semaurer01/Senior_project/README.md

This is the Git Hub Ropository for My senior project. I am using it to store and track changes in my design and record my progress.
