semaurer01/Senior_project/wires.txt

Resistor Values
R1=1.8kΩ
R2=1.9kΩ
R3=10kΩ

Arduino
Arduino GND        |GND
Arduino Vin        |5v

GPS
GPS QWIIC          |Arduino QWIIC

MPU
MPU VCC            |5v
MPU GND            |GND
MPU SCL            |Arduino D19
MPU SDA            |Arduino D18
MPU AD0            |5v

Bluetooth
BT Vcc             |5v
BT GND             |GND
BT Tx              |Andiuno D1
BT Rx              |NODE 1

ESC
ESC GND            |GND
ESC 5v             |5v
ESC input          |Arduino D8

Servo
Servo GND          |GND
Servo 5v           |5v
Servo input        |Arduino D4

Speedometers
speedometer1 Vcc   |5v
speedometer1 GND   |GND
speedometer1 out   |Arduino D2

speedometer2 Vcc   |5v
speedometer2 GND   |GND
speedometer2 out   |Arduino D3

Input Switches
S1-                |Arduino D5
S1+                |5v

Resistors
R1+                |Arduino D0
R1-                |Node 1
R2+                |NODE 1
R2-                |GND
R3+                |Arduino D5
R3-                |GND
