semaurer01/Senior_project/print_files/lid.stl

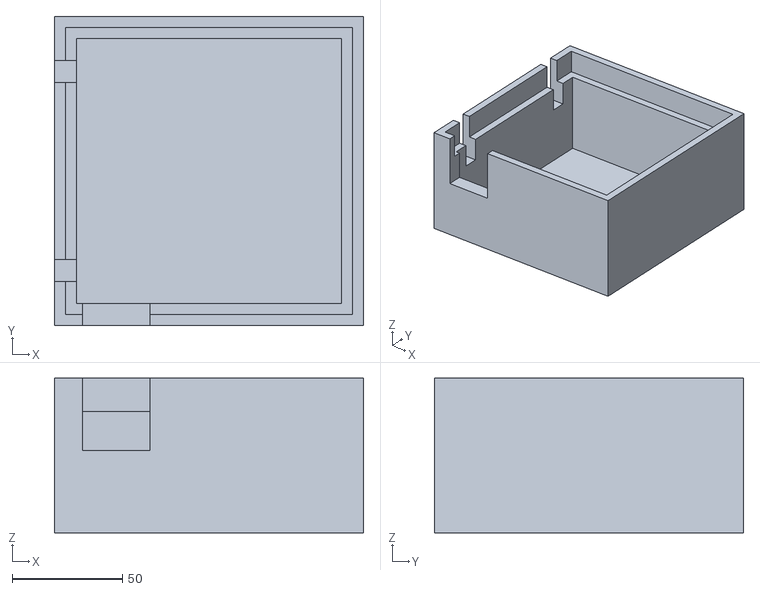
[picture p1: CAD file, 2026-04-15]
print_files/lid.stl
140.0 x 140.0 x 70.0
