semaurer01/Senior_project/print_files/Interuptor.stl

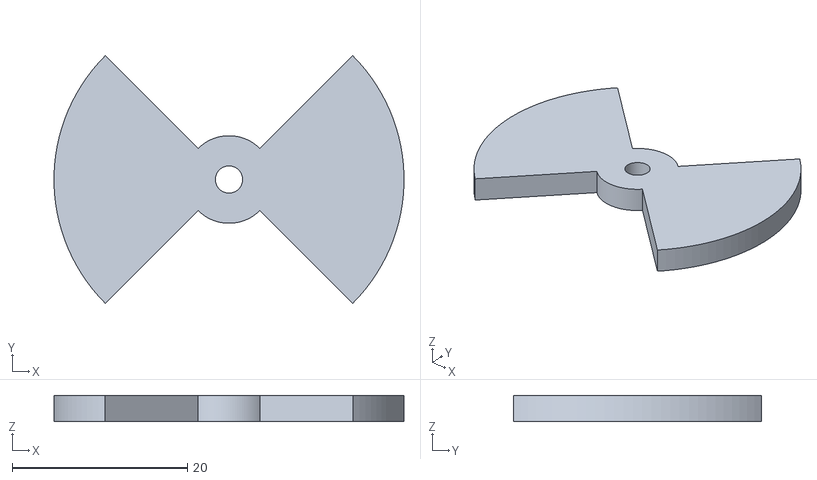
[picture p2: CAD file, 2026-04-10]
print_files/Interuptor.stl
40.0 x 28.3 x 3.00
