semaurer01/Senior_project/print_files/Gear Box Top.stl

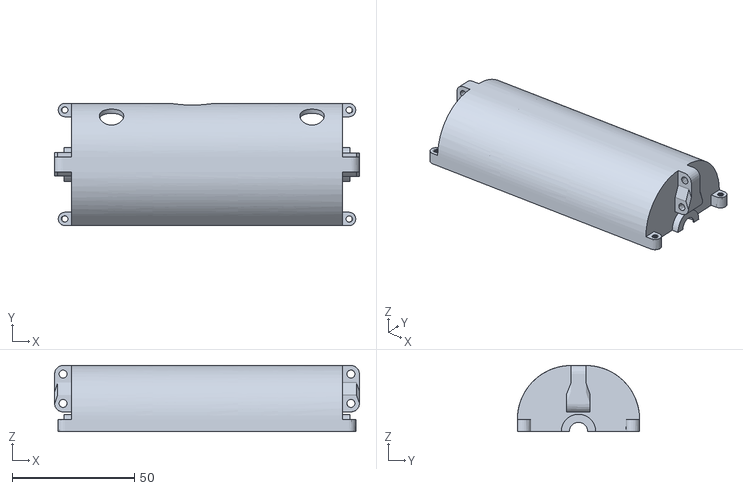
[picture p3: CAD file, 2026-03-26]
print_files/Gear Box Top.stl
124.7 x 50.0 x 27.0
