semaurer01/Senior_project/print_files/Base.stl

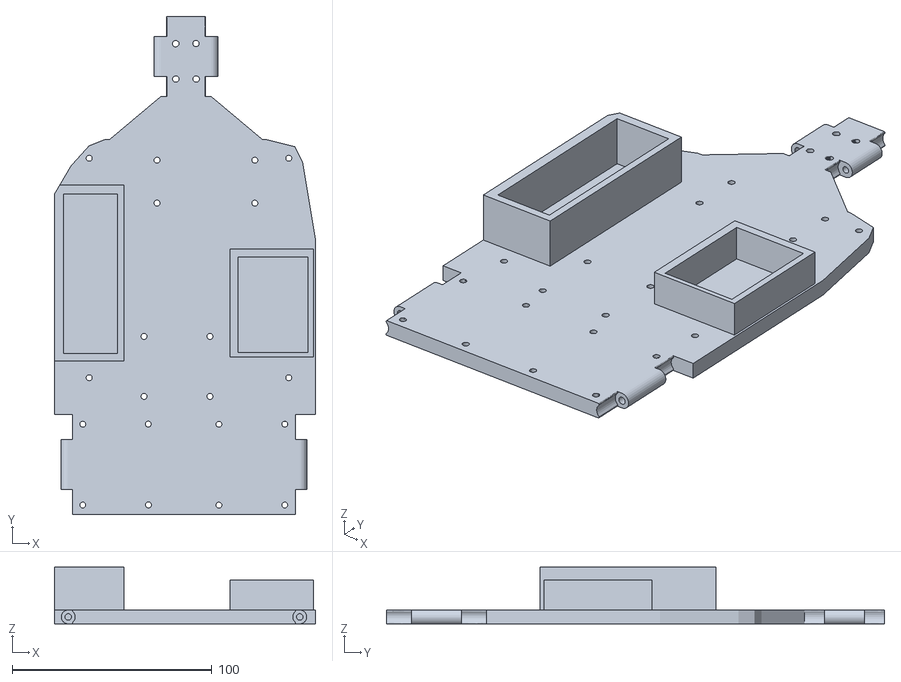
[picture p4: CAD file, 2026-03-26]
print_files/Base.stl
131.0 x 249.5 x 28.5
