semaurer01/Senior_project/print_files/Gear Box Bottom.stl

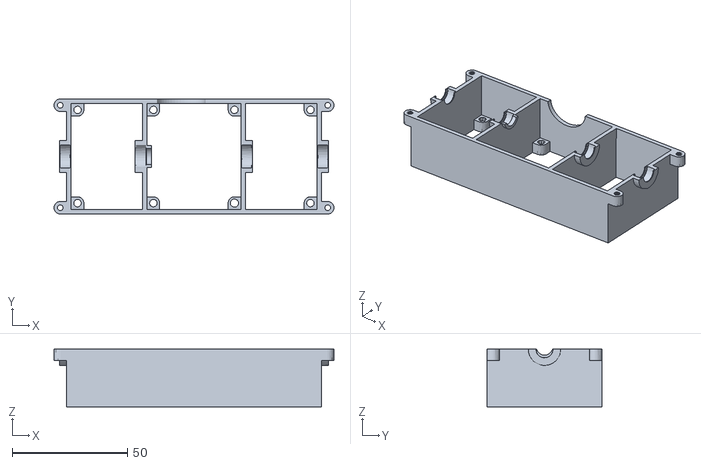
[picture p5: CAD file, 2026-03-26]
print_files/Gear Box Bottom.stl
121.6 x 50.0 x 25.0
