semaurer01/Senior_project/print_files/Front arm top.stl

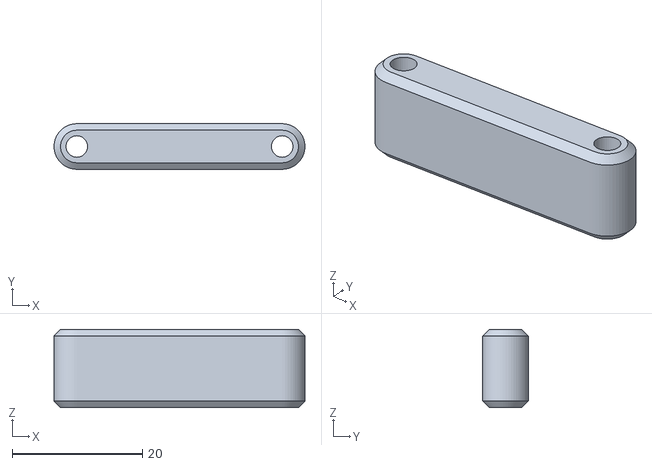
[picture p6: CAD file, 2026-02-25]
print_files/Front arm top.stl
38.5 x 7.00 x 12.0
