semaurer01/Senior_project/print_files/Large gear.stl

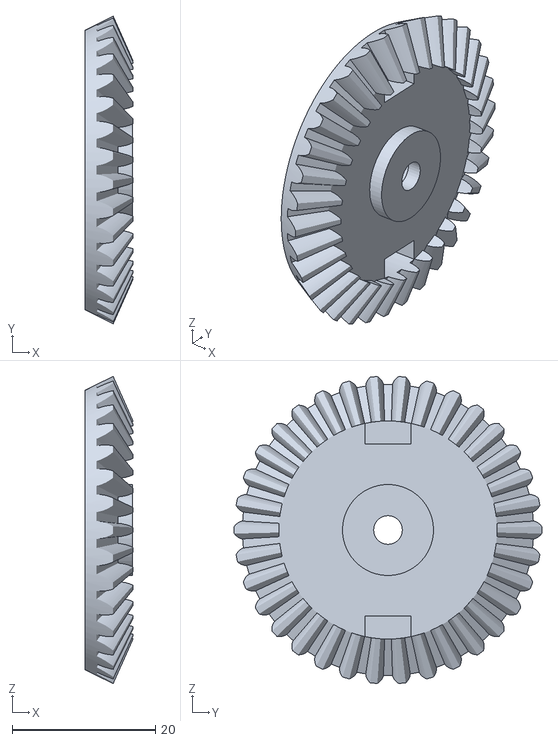
[picture p7: CAD file, 2026-02-25]
print_files/Large gear.stl
6.74 x 43.0 x 42.9
