semaurer01/Senior_project/print_files/Back Suspension.stl

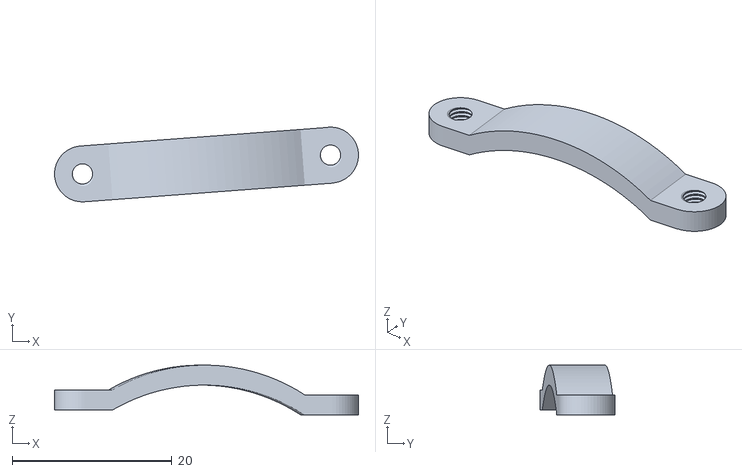
[picture p8: CAD file, 2026-02-25]
print_files/Back Suspension.stl
38.0 x 9.35 x 6.22
