semaurer01/Senior_project/print_files/Back Tyre.stl

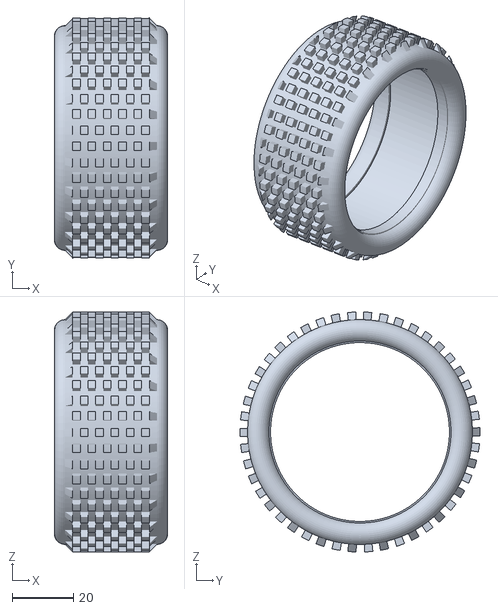
[picture p9: CAD file, 2026-02-25]
print_files/Back Tyre.stl
37.0 x 78.4 x 78.4
