semaurer01/Senior_project/print_files/Front Tire.stl

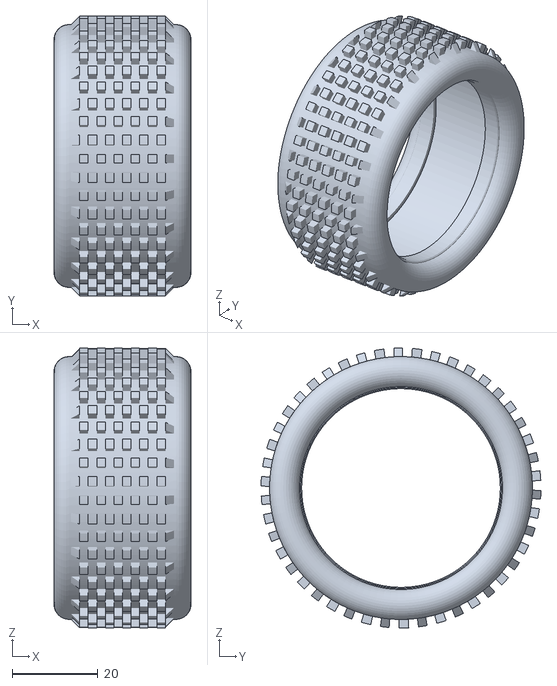
[picture p10: CAD file, 2026-02-25]
print_files/Front Tire.stl
32.0 x 65.4 x 65.4
