semaurer01/Senior_project/print_files/Back wheel.stl

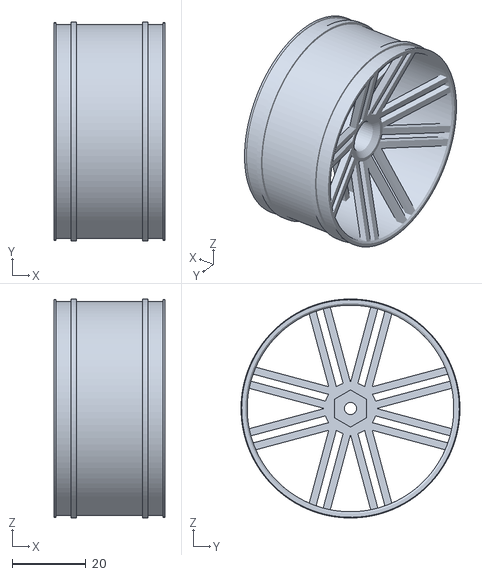
[picture p11: CAD file, 2026-02-25]
print_files/Back wheel.stl
30.0 x 59.4 x 59.4
