semaurer01/Senior_project/print_files/Back Arm.stl

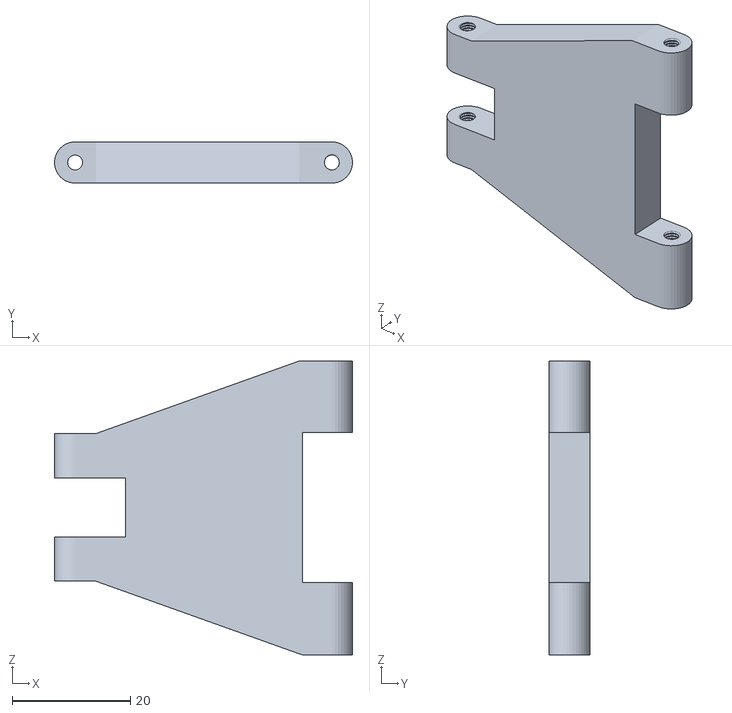
[picture p12: CAD file, 2026-02-25]
print_files/Back Arm.stl
50.5 x 7.00 x 49.8
