semaurer01/Senior_project/print_files/Small Gear.stl

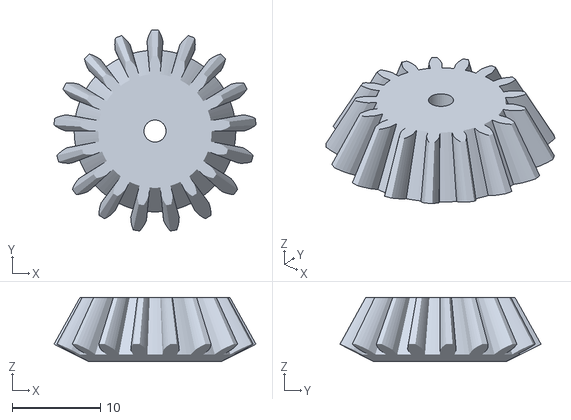
[picture p13: CAD file, 2026-02-25]
print_files/Small Gear.stl
22.9 x 22.8 x 7.28
