semaurer01/Senior_project/print_files/Front Right arm.stl

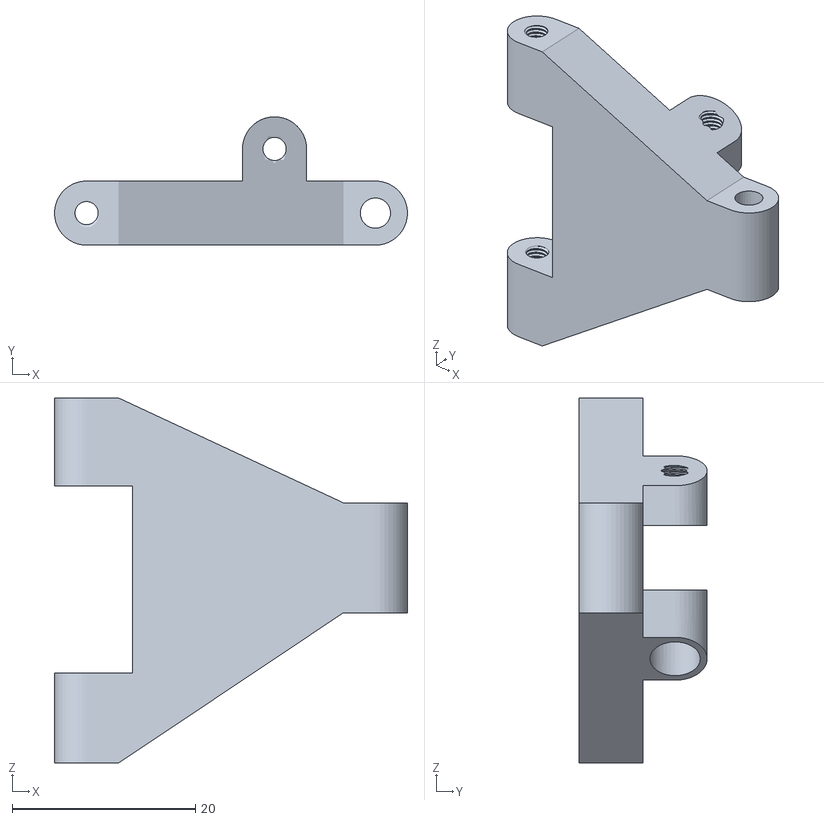
[picture p14: CAD file, 2026-02-25]
print_files/Front Right arm.stl
38.5 x 14.0 x 39.8
