semaurer01/Senior_project/print_files/Front Suspension.stl

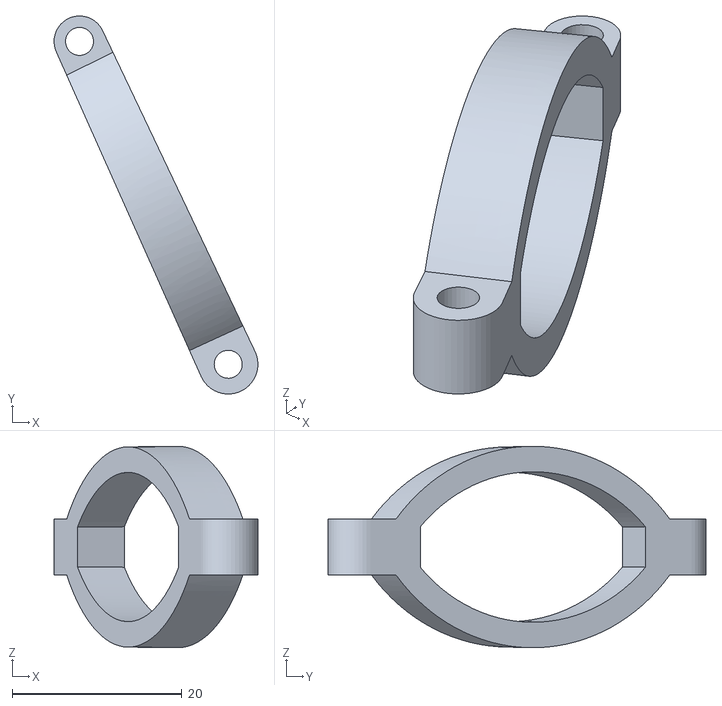
[picture p15: CAD file, 2026-02-25]
print_files/Front Suspension.stl
24.0 x 44.5 x 23.7
