semaurer01/Senior_project/print_files/Gear Arm.stl

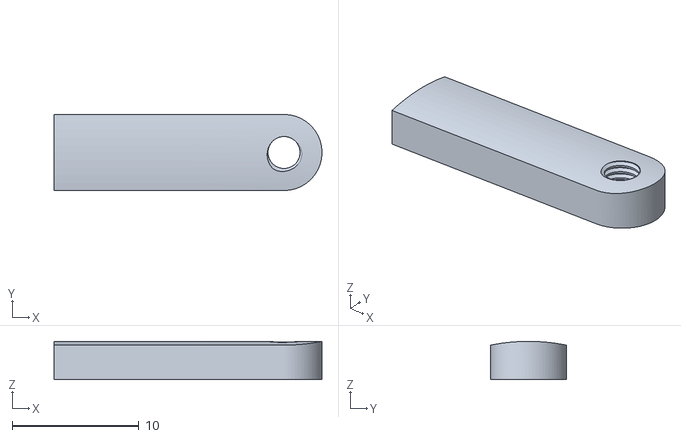
[picture p16: CAD file, 2026-02-25]
print_files/Gear Arm.stl
21.2 x 6.00 x 3.02
