semaurer01/Senior_project/print_files/trellis.stl

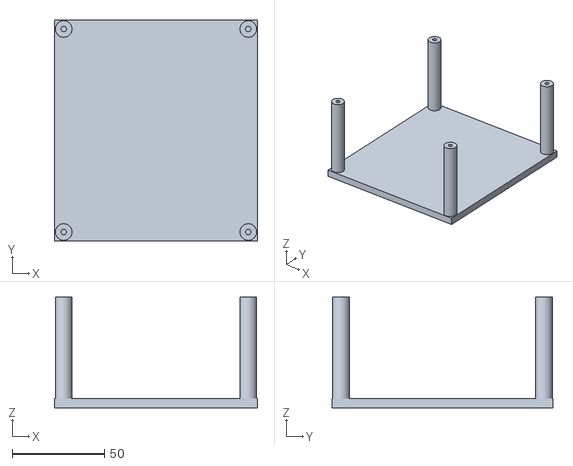
[picture p17: CAD file, 2026-02-25]
print_files/trellis.stl
110.0 x 120.0 x 60.0
