semaurer01/Senior_project/print_files/Inner Driver Gear.stl

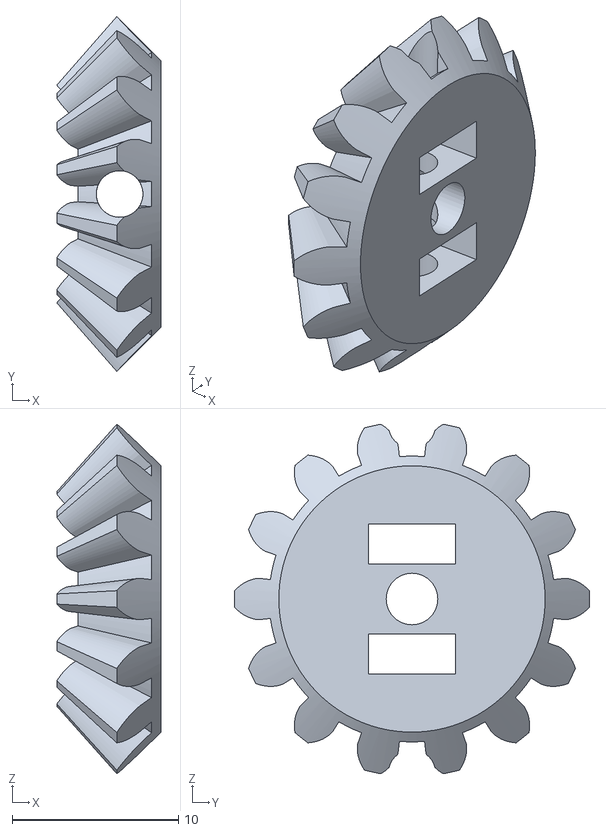
[picture p18: CAD file, 2026-02-25]
print_files/Inner Driver Gear.stl
6.28 x 21.3 x 21.0
