semaurer01/Senior_project/print_files/Front Steering center.stl

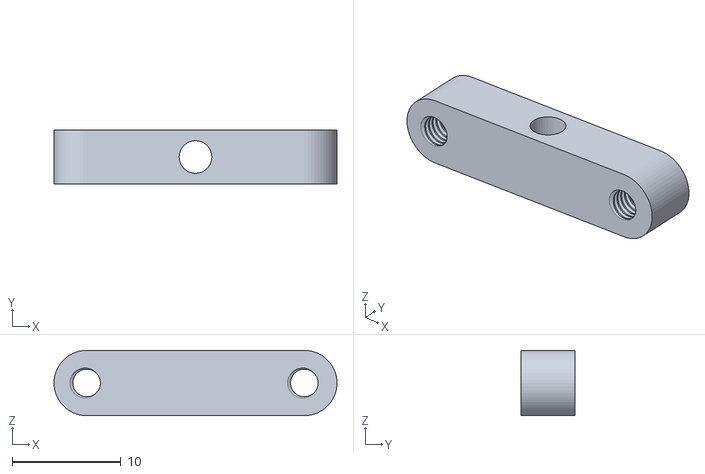
[picture p19: CAD file, 2026-02-25]
print_files/Front Steering center.stl
26.0 x 5.00 x 6.00
