semaurer01/Senior_project/print_files/Steering Bracket.stl

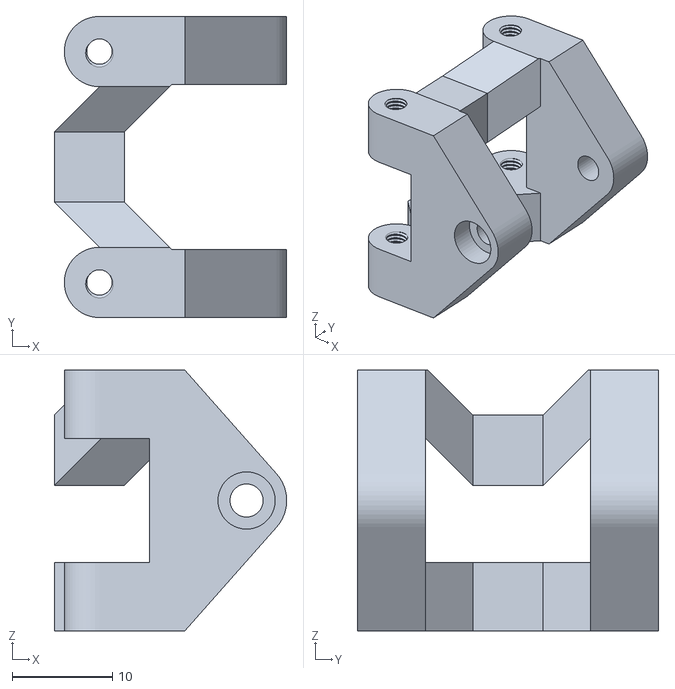
[picture p20: CAD file, 2026-02-25]
print_files/Steering Bracket.stl
23.2 x 30.0 x 26.0
