semaurer01/Senior_project/print_files/Gearbox Connector.stl

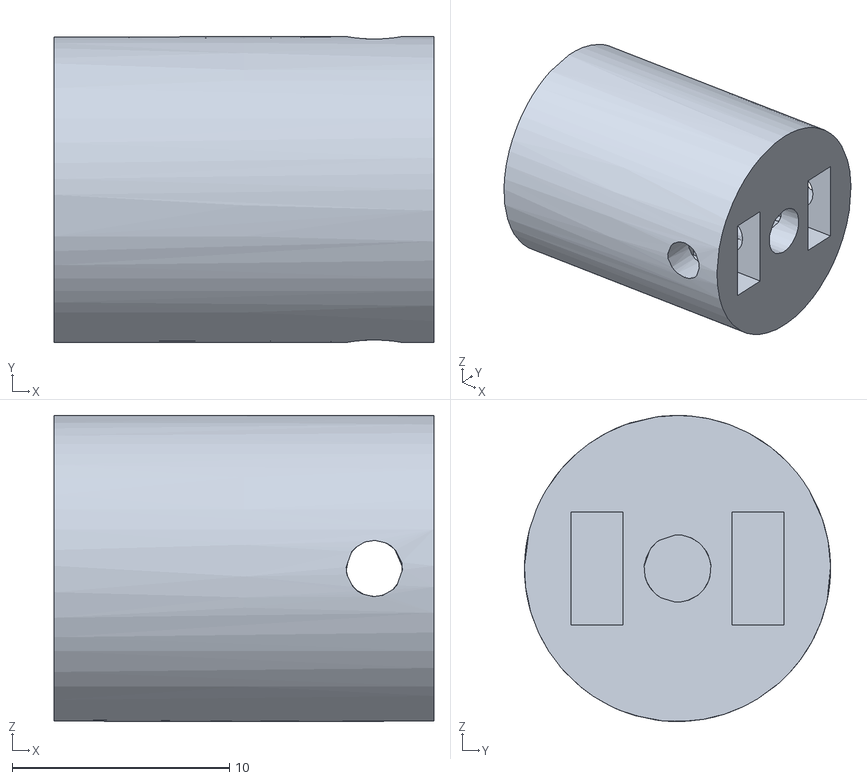
[picture p21: CAD file, 2026-02-25]
print_files/Gearbox Connector.stl
17.5 x 14.1 x 14.1
