semaurer01/Senior_project/print_files/Back Wheel Connector.stl

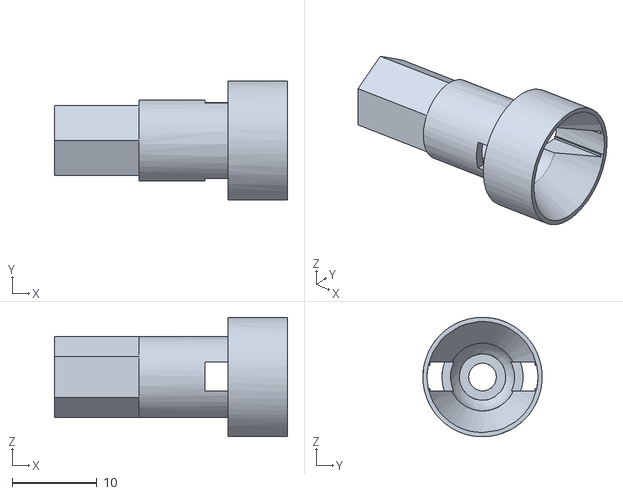
[picture p22: CAD file, 2026-02-25]
print_files/Back Wheel Connector.stl
27.5 x 14.1 x 14.1
