semaurer01/Senior_project/print_files/Back+top+arm.stl

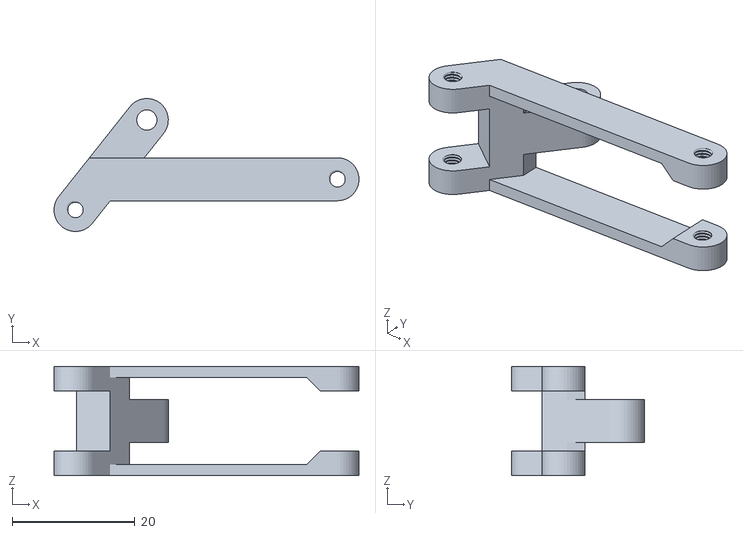
[picture p23: CAD file, 2026-02-25]
print_files/Back+top+arm.stl
49.6 x 21.6 x 17.8
