semaurer01/Senior_project/print_files/Driver arm.stl

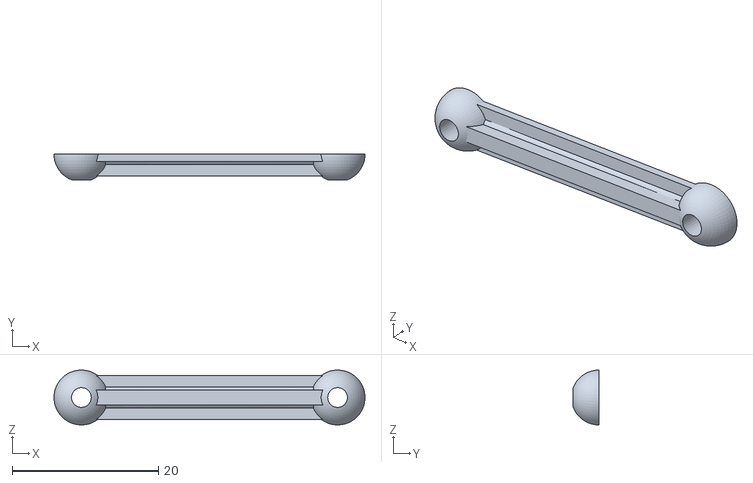
[picture p24: CAD file, 2026-02-25]
print_files/Driver arm.stl
42.5 x 3.50 x 7.49
