semaurer01/Senior_project/print_files/Front Steering arm.stl

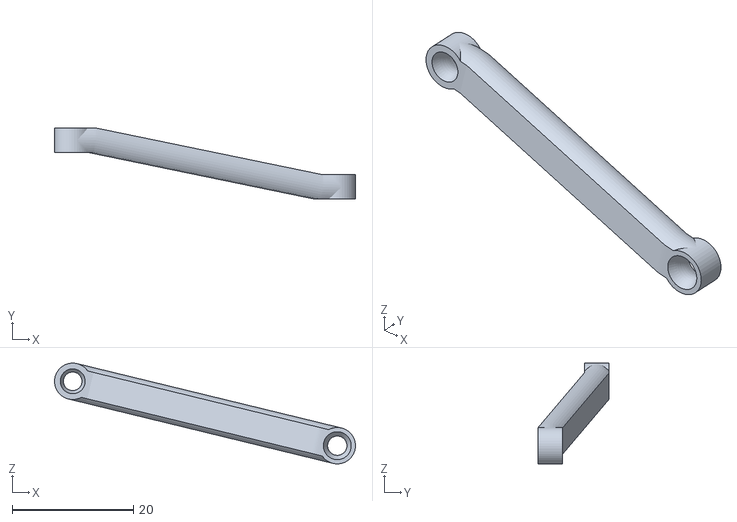
[picture p25: CAD file, 2026-02-25]
print_files/Front Steering arm.stl
49.6 x 11.7 x 16.6
