semaurer01/Senior_project/print_files/Inner gear.stl

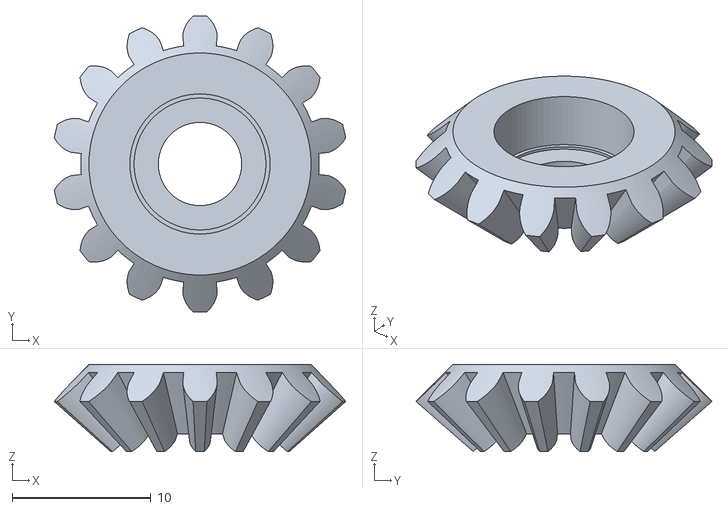
[picture p26: CAD file, 2026-02-25]
print_files/Inner gear.stl
21.0 x 21.3 x 6.28
