semaurer01/Senior_project/print_files/Wheel Bracket Right.stl

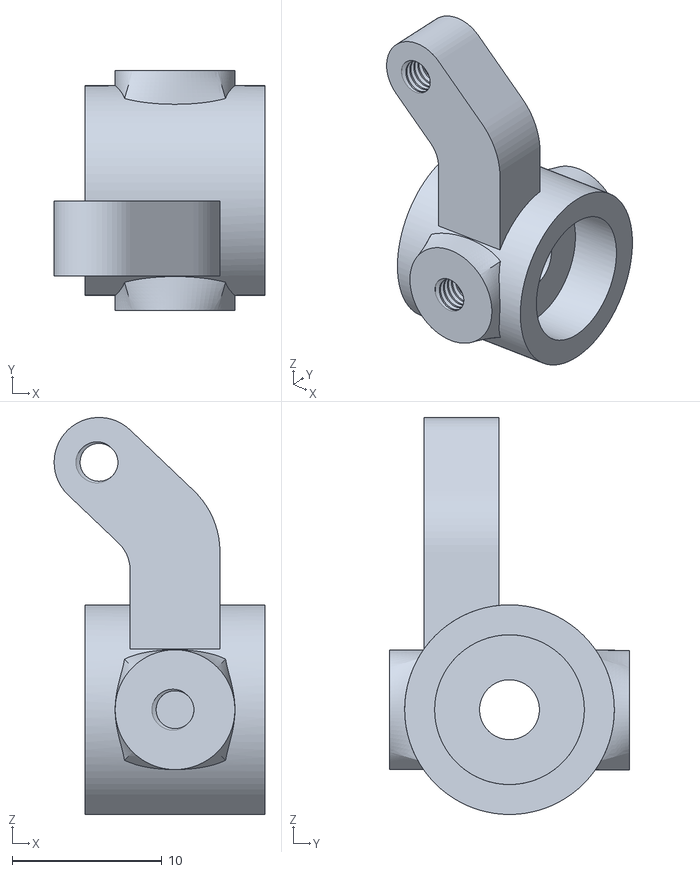
[picture p27: CAD file, 2026-02-25]
print_files/Wheel Bracket Right.stl
14.1 x 16.0 x 26.5
