semaurer01/Senior_project/print_files/Front wheel.stl

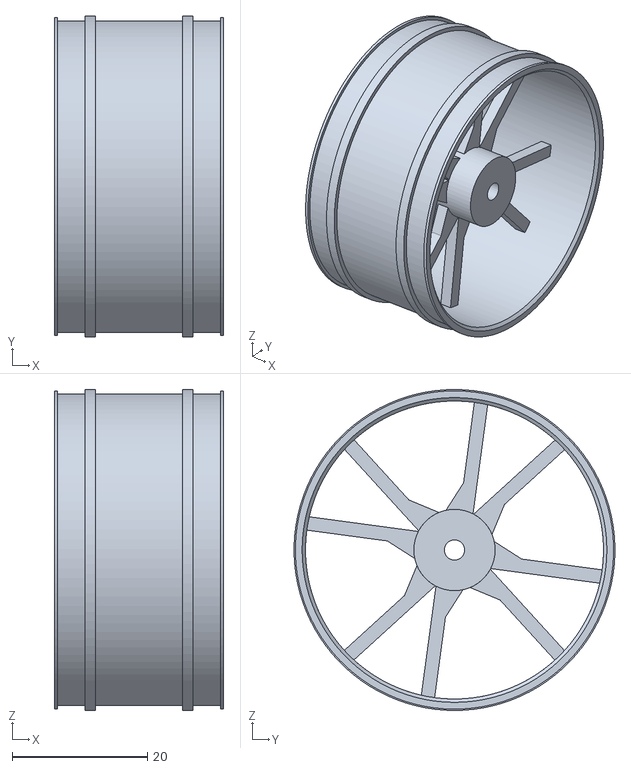
[picture p28: CAD file, 2026-02-25]
print_files/Front wheel.stl
25.0 x 47.4 x 47.4
