semaurer01/Senior_project/print_files/Motor mount.stl

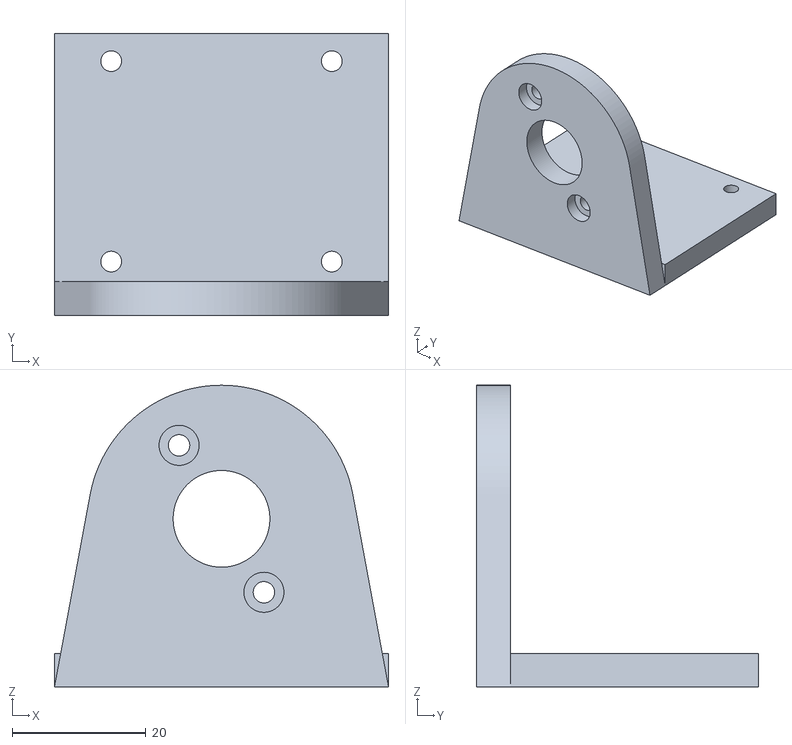
[picture p29: CAD file, 2026-02-25]
print_files/Motor mount.stl
50.0 x 42.2 x 45.1
