semaurer01/Senior_project/print_files/Servo mount.stl

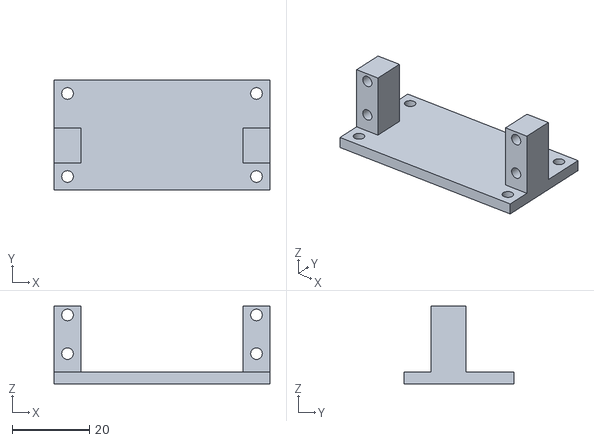
[picture p30: CAD file, 2026-02-25]
print_files/Servo mount.stl
55.9 x 28.5 x 20.1
