semaurer01/Senior_project/(list of files, cad)

Other CAD files:
print_files/Front Left Arm.stl
print_files/Front arm Bracket.stl
print_files/Wheel Bracket Left.stl
print_files/Long washer.stl
