semaurer01/Senior_project/(commit log)

2026-01-28 added Servo test for verifying servo functionality (the steering servo works)
2026-01-29 designed method to test the functionality of the bluetooth device
2026-01-31 This code verifies the connectivity of IIC devices.
2026-02-03 Fixed configuration issues in the setup function allowing the GPS to opperate over QWIIC (WIRE 1) reliably.
    [GPS_test.ino]
2026-02-24 allows the user to set the angle of the servo with macros. This fixes the problem of the motor overthottling and tearing the car apart.
    [Servo_test.ino]
2026-02-24 This will be the main program the vehicle runs while on the course however it currently does nothing and is only a place to put stuff while I figure out how it works
2026-02-25 Added throttle and steering so now the Machine can drive in a strait line.
2026-02-25 This is a file to test the gyroscope and accelerometer module and to measure the offsets caused by the imprecision of the system.
2026-02-25 add print files
    I was advised that the printing files should be in the Github repository so I am adding them now.
    [Back Tyre.stl, Back Wheel Connector V2.stl, Back wheel.stl, Back+Arm.stl, Back+Suspension.stl, Back+top+arm.stl, Base V3.stl, Driver+arm.stl]
2026-02-25 creating folder to store print files
    [Back Tyre.stl]
2026-02-25 put back wheel connector into print_files
    [Back Wheel Connector.stl]
2026-02-25 Rename Back wheel.stl to print_files/Back wheel.stl
    [Back wheel.stl]
2026-02-25 Rename Back+Arm.stl to print_files/Back Arm.stl
    [Back Arm.stl]
2026-02-25 Rename Back+Suspension.stl to print_files/Back Suspension.stl
    [Back Suspension.stl]
2026-02-25 Rename Base V3.stl to print_files/Base.stl
    [Base.stl]
2026-02-25 Rename Driver+arm.stl to print_files/Driver arm.stl
    [Driver arm.stl]
2026-02-25 Rename Front+Left+Arm.stl to print_files/Front Left Arm.stl
    [Front Left Arm.stl, Front+Left+Arm.stl]
2026-02-25 Rename Front+Right+arm.stl to print_files/Front Right arm.stl
    [Front Right arm.stl]
2026-02-25 Rename Front+Steering+arm.stl to print_files/Front Steering arm.stl
    [Front Steering arm.stl]
2026-02-25 Rename Front+Steering+center.stl to print_files/Front Steering center.stl
    [Front Steering center.stl]
2026-02-25 Rename Front+Suspension.stl to print_files/Front Suspension.stl
    [Front Suspension.stl]
2026-02-25 Rename Front+Tyre.stl to print_files/Front Tire.stl
    [Front Tire.stl]
2026-02-25 Rename Front+arm+Bracket.stl to print_files/Front arm Bracket.stl
    [Front arm Bracket.stl, Front+arm+Bracket.stl]
2026-02-25 Rename Front+arm+top.stl to print_files/Front arm top.stl
    [Front arm top.stl]
2026-02-25 Rename Front+wheel.stl to print_files/Front wheel.stl
    [Front wheel.stl]
2026-02-25 Rename Gear+Arm.stl to print_files/Gear Arm.stl
    [Gear Arm.stl]
2026-02-25 Rename Gear+Box+Bottom.stl to print_files/Gear Box Bottom.stl
    [Gear Box Bottom.stl]
2026-02-25 Rename Gear+Box+Top.stl to print_files/Gear Box Top.stl
    [Gear Box Top.stl]
2026-02-25 Rename Gearbox Connector V2.stl to print_files/Gearbox Connector.stl
    [Gearbox Connector.stl]
2026-02-25 Rename Inner+Driver+Gear.stl to print_files/Inner Driver Gear.stl
    [Inner Driver Gear.stl]
2026-02-25 Rename Inner+gear.stl to print_files/Inner gear.stl
    [Inner gear.stl]
2026-02-25 Rename Large+gear.stl to print_files/Large gear.stl
    [Large gear.stl]
2026-02-25 Rename Long+washer.stl to print_files/Long washer.stl
    [Long washer.stl]
2026-02-25 Rename Motor_mount-v4.stl to print_files/Motor mount.stl
    [Motor mount.stl]
2026-02-25 Rename Servo_mount_v3.stl to print_files/Servo mount.stl
    [Servo mount.stl]
2026-02-25 Rename Small+Gear.stl to print_files/Small Gear.stl
    [Small Gear.stl]
2026-02-25 Rename Steering+Bracket.stl to print_files/Steering Bracket.stl
    [Steering Bracket.stl]
2026-02-25 Rename Wheel_Bracket_Left.stl to print_files/Wheel Bracket Left.stl
    [Wheel Bracket Left.stl, Wheel_Bracket_Left.stl]
2026-02-25 Rename Wheel_Bracket_Right.stl to print_files/Wheel Bracket Right.stl
    [Wheel Bracket Right.stl]
2026-02-26 fixed holes in wrong spot on Base. And improved corners
    [Base.stl]
2026-02-27 Create wires.txt
    Added a file to track the design of the wiring and connection layout. filled it with current design.
2026-02-28 Implemented basic form of Kalman filter that only tracks heading
2026-03-03 switched to more standardized matrix arithmatic to simplify apearances and to avoid mistakes.
    [Senior_project.ino]
2026-03-03 Update wires.txt to include the addition of Motors
2026-03-06 editted gearbox to add a buffet around the large gear so that it has a small contact point and presses against the motor better.
    [Gear Box Bottom.stl, Gear Box Top.stl]
2026-03-09 added control for a stopped state, which updates the start position and the gyro bias of the machine. added steering control to seek waypoints. added waypoint navigation.
2026-03-09 added input switch 1
2026-03-26 edited gearbox to hold the gears better and to make room for the interuptors
    [Base.stl, Gear Box Bottom.stl, Gear Box Top.stl]
2026-03-27 created program to work both speedometers at the same time. It cannot be tested without the gearbox functioning better.
2026-03-27 added speedometer wiring
2026-03-30 mpu offsets are not actually needed because the Kalman Filter takes care of this
2026-04-08 Added the spedometer code to Senior project but this is not fully tested because the gearbox is broken and the interuptors don't work.
    [Senior_project.ino]
2026-04-10 added Interuptor
    [Interuptor.stl]
2026-04-15 add lid
    [lid.stl]
2026-04-15 created double speedometer tuner to determine the effective wheel size that is the ratio between the number of turns reported and the distance
2026-04-16 added simple throttle curvature to lighten load on gears
2026-04-16 bug: typo in waypoints
    this was not entered correctly before now it matches my notes
    [Senior_project.ino]
2026-04-17 bug: throttling to quickly and destroying the gearbox
    [Senior_project.ino]
2026-04-17 hack: changed the system to use the same throttle variable but scale it by two this doubles the system throttle time
2026-04-17 using the throttle scalar to slow the acceleration at start
